analogchipper/NanoArchitects_Chipathon2026/README_backup.md

# Gas Sensor AFE ASIC — Team NanoArchitects

**IEEE SSCS Chipathon 2026, Track B** · GF180MCU 180nm CMOS PDK

Dual-modal analog front-end ASIC for simultaneous MOX (metal-oxide) and EC (electrochemical) gas sensing.

| Feature | Description |
|---|---|
| **EC sensors** | Selective but slow — good for identifying gas type |
| **MOX sensors** | Fast response but lack selectivity — good for real-time detection |
| **Both in parallel** | Enables real-time cross-validation |
| **Target applications** | Industrial toxic-gas detection (CO, H₂S), VOC monitoring, process control |

## Block Diagram

GasSensorChip_Chipathon drawio(1)

## Status: All blocks complete ✅

| Block | Status |
|---|---|
| EC TIA | ✅ Complete |
| MOX Integrator + Reset Sw. | ✅ Complete |
| Output Buffers | ✅ Complete |
| Bias Generator (BGR) | ✅ Complete |
| Comparators | ✅ Complete |

## Key Specifications

### Op-Amp (`opamp_poly`)

📄 [Full Datasheet (PDF)](docs/datasheets/OPAMP_Datasheet.pdf)

| Parameter | Value |
|---|---|
| Open-Loop Gain | 80.3 dB |
| Unity-Gain BW | 154.6 MHz |
| Phase Margin | 70.2° |
| CMRR | 102.8 dB |
| PSRR | 81.9 dB |
| Slew Rate (+/-) | 194.4 / 96.0 V/µs |
| Input Common-Mode Range | 38 mV – 3.06 V |
| Output Swing | 0 V – 3.23 V @ VDD = 3.3 V |
| Quiescent Current | 943 µA |

### EC Channel — TIA

| Parameter | Value |
|---|---|
| Open-Loop Gain | 74 dB |
| Phase Margin | 65° (unconditionally stable) |
| Bandwidth | 5 MHz |
| Rf ∥ Cf | 7 kΩ ∥ 9 pF |
| Input Range | 100 nA (2.7995 V) – 373 µA (0.935 V) |
| Full Swing | ≈ 1.865 V, single output, no range switching |

### MOX Channel — Integrator (Methane sensor)

| Parameter | Value |
|---|---|
| Clean-Air Resistance (R0) | 20–70 kΩ |
| Gas-Present Resistance (RS) | 2–20 kΩ @ 5000 ppm methane |
| Integrator Current Range | 14 µA – 500 µA |
| System Parameters | Vp = 1.3 V, ΔV = 0.5 V, Cint = 10 µF |
| Reset Pin | `RESET_INT`, active-high, MCU-controlled |

### Bias Generator (BGR)

| Parameter | Value |
|---|---|
| Reference Voltage | 1.2 V bandgap core, scaled to Vp = 2.8 V |
| Supply Voltage | 3.3 V |
| Temp. Coefficient | < 50 ppm/°C |
| Power Consumption | < 50 µA |

**Multi-rail bias distribution.** The BGR core outputs a single reference (`Vref`), which is buffered through `OPAMP_silicon` (unity-gain, driven from the same op-amp used elsewhere on-chip) and then divided through a resistor ladder (R1–R4) to generate every bias voltage the other blocks need: `v_2.8` (EC TIA virtual ground), `voref`, and `v_1.3` / `v_0.8` (MOX integrator system voltages). Using a single buffered reference plus a resistor ladder — instead of separate bandgap cores per block — keeps all bias points ratiometrically matched and saves die area.

## Pin Assignment (~15 pads)

Pin Assignment

## Estimated Die Area

**Total: 0.5 – 0.6 mm²**

---

## Simulation Results

### Op-Amp

**🔗 [View Op-Amp schematic file (`opamp_poly.sch`)](xschem/opamp/opamp_poly.sch)**

| Schematic | AC Bode (Gain 80 dB) | Phase Margin (70°) |
|---|---|---|
| Opamp Schematic | AC Bode | Phase |

| CMRR (102 dB) | PSRR (81.9 dB) | ICMR(0.2 - 3.1 V) |
|---|---|---|
| CMRR | PSRR | ICMR |

**Slew Rate:** rising SR = 194.4 V/µs, falling SR = 96.0 V/µs — asymmetry expected due to sourcing/sinking drive imbalance in the output stage (confirmed against datasheet).

Slew Rate
**Op-Amp Summary:** The AC response confirms a high open-loop gain (>80 dB) and excellent stability with a 70.2° phase margin. High CMRR (>102 dB) and PSRR (>81 dB) ensure the amplifier remains highly robust against supply noise and common-mode fluctuations, which is essential for accurate, low-noise sensor signal conditioning. 

### Output Buffers

**🔗 [View Buffer schematic file (`buffer.sch`)](xschem/output_buffer/buffer.sch)**

**Buffer Schematic:**
Output Buffer Schematic

**Transient Waveform:**
Buffer Transient Waveform

**Buffer Summary:** The operational amplifier buffer provides essential signal isolation and drive capabilities. It is instantiated twice within the AFE architecture: (1) to provide sufficient drive strength to pass the EC TIA output voltage to an off-chip ADC, and (2) to supply a highly stable, low-impedance reference bias to the MOX integrator. The transient simulations verify that the buffer faithfully tracks dynamic signals with excellent settling time and minimal distortion under load.

### Comparators

**🔗 [View Comparator schematic file (`comparator.sch`)](xschem/comparator/comp.sch)**

**Comparator Schematic:**
Comparator Schematic

**Transient Waveform:**
Comparator Transient Waveform

 **Comparator Summary:** The comparator acts as the critical bridge between the analog sensor front-end and the digital logic domain, providing precise threshold detection to trigger system alerts or wake-up events when gas concentrations exceed predefined safety levels. The transient simulation validates its fast response and confirms its inverting topology: the output drives low (0) when the sensor signal exceeds the reference voltage (Vin > Vref), and transitions high (1) when it drops below the threshold. This active-low configuration ensures reliable event triggering for downstream digital processing.

---
### EC TIA

**🔗 [View TIA schematic file (`TIA.sch`)](xschem/ec_tia/TIA.sch)**

**🔗 [View Top-Level Sensor System schematic file (`ECSensorSim.sch`)](xschem/ec_tia/ECSensorSim.sch)**

TIA Schematic

**AC response and DC linearity:**

| AC Bode | DC Sweep (Vout vs Iin) |
|---|---|
| TIA AC Bode | TIA DC Sweep |

**Input/output noise spectrum:**

| Input-Referred Noise | Output Noise |
|---|---|
| Input Noise | Output Noise |

**Gas response (CO sensor):**

| Sensor Concentration(ppm) vs Current(uA) | Sensor Concentration(ppm) vs ADC code |
|---|---|
| Sensor Concentration(ppm) vs Current(uA) | Sensor Concentration(ppm) vs ADC |
**TIA Summary:** The Transimpedance Amplifier achieves excellent DC linearity across the entire 100 nA to 373 µA input range, directly translating into accurate ppm gas readings. The AC Bode plot confirms unconditional stability (65° phase margin), while the noise spectrum analysis demonstrates minimal input-referred noise—a critical requirement for resolving minute electrochemical sensor currents.

### MOX Integrator

**🔗 [View MOX Integrator schematic file (`integrator.sch`)](xschem/mox_integrator/int.sch)**

**Integrator Schematic:**
MOX Integrator Schematic

**Transient Waveform:**
MOX Integrator Transient Waveform
MOX Integrator Transient Waveform

Note:To prevent the reset mechanism from stalling, the lower comparator threshold is set to 1.5V keeping it safely above the 1.3V reference
**MOX Integrator Summary:** The MOX sensor acts as a variable resistor where its resistance changes according to the environmental gas concentration. This varying resistance dictates the amount of current entering the integrator's capacitor, which changes the time it takes for the output voltage to ramp from a 1.3V reference baseline up to a 2.5V threshold. An external MCU measures this specific ramp time to accurately determine the sensor resistance, which directly reflects the real-time gas concentration as can be seen in the above results.
### Bias Generator (BGR)

**🔗 [View BGR schematic file (`BGR_BJT.sch`)](xschem/bias_generator/BGR_BJT.sch)**

**BGR Core Schematic:**
BGR Schematic

**Multi-Bias Distribution Schematic:**
Multi-Bias Distribution Schematic

**Simulation Results:**
BGR U-curve
Multiple Bias Generation
**BGR Summary:** The U-curve validates a highly stable reference voltage with a temperature coefficient of less than 50 ppm/°C across the target thermal operating range. The multi-bias generation network successfully buffers and scales this core voltage to provide clean, ratiometrically matched sub-rails (2.8V, 1.3V, and 0.8V) for all other on-chip blocks.
---

### Overall Circuit

**Circuit Schematic:** [Insert Link]

**Circuit Simulation Demo Video:** [Insert Link]

**System Simulation Results**

#### EC TIA System Linearity
Full-system simulations under load(worst case load value was taken 100pF) indicate a maximum linear TIA current limit of 340 µA. This comfortably exceeds the requirements of our target application, as the most demanding sensor (Carbon Monoxide) reaches a maximum output of only 102 µA at 1000 ppm. The table below characterizes the TIA's linearity up to this physical saturation limit (Mean Absolute Deviation: 1.97%).

| Vref (V) | I (µA) | Vout Calculated (V) | Vout Simulated (V) | Deviation (%) |
| :--- | :--- | :--- | :--- | :--- |
| 2.726 | 20 | 2.586 | 2.583 | -0.12% |
| 2.726 | 60 | 2.306 | 2.297 | -0.39% |
| 2.726 | 100 | 2.026 | 2.011 | -0.74% |
| 2.726 | 140 | 1.746 | 1.732 | -0.80% |
| 2.726 | 180 | 1.466 | 1.447 | -1.30% |
| 2.726 | 220 | 1.186 | 1.161 | -2.11% |
| 2.726 | 260 | 0.906 | 0.8747 | -3.45% |
| 2.726 | 300 | 0.626 | 0.5895 | -5.83% |
| 2.726 | 340 | 0.346 | 0.3522 | 1.79% |

#### MOX Integrator System Characterization
The table below validates the system-level integrator performance across heavy gas leaks (2 kΩ) to clean air baselines (60 kΩ), demonstrating an exceptionally low Mean Absolute Deviation of just 2.79% from theoretical calculations.

| VR (V) | C (nF) | Rs (kΩ) | Calculated Time (ms) | Simulated Time (ms) | Deviation (%) |
| :--- | :--- | :--- | :--- | :--- | :--- |
| 0.5 | 33 | 2 | 0.132 | 0.1288 | -2.42% |
| 0.5 | 33 | 20 | 1.320 | 1.3386 | +1.41% |
| 0.5 | 33 | 60 | 3.960 | 3.7799 | -4.55% |

## Repository Structure

├── docs/
│   ├── datasheets/      Component datasheets (PDF)
│   └── images/          Diagrams and simulation plots used in this README
├── xschem/              Schematic source files (.sch, .sym), one folder per block
│   ├── bias_generator/
│   ├── comparator/
│   ├── ec_tia/
│   ├── mox_integrator/
│   ├── opamp/
│   ├── output_buffer/
│   └── afe_top/       Overall AFE system integration schematic
├── simulations/          Testbenches and .raw sim data
└── layout/               (in progress) GDS/layout files, DRC/LVS reports
```
## Team NanoArchitects

- Alaqmar
- Ankith B.
- Rishi Raghav S.
- Shaik Kareena
