analogchipper/NanoArchitects_Chipathon2026/(commit log)

2026-07-04 Update README.md for clarity and formatting
    Removed out-of-range note for H₂S sensor and cleaned up team member list formatting.
2026-07-10 README Updated
    [ECSensorSim.sch, ECSensorSim_dc.sch, ECSensorSim_ppm.sch, ECSensorSim_ppm_CO.sch, ECSensorSim_ppm_H2S.sch, TIA.sch, TIA_PVT_phase_sil.sch, TIA_PVT_sil.sch]
2026-07-10 update README with opamp/TIA/BGR sim results and datasheet link
    [BGR_BJT.sch, BGR_BJT_dc.sch, ECSensorSim.sch, ECSensorSim_dc.sch, ECSensorSim_ppm.sch, ECSensorSim_ppm_CO.sch, ECSensorSim_ppm_H2S.sch, TIA.sch]
2026-07-10 add BGR multi-bias distribution schematic and explanation
2026-07-12 Update README with multi-bias distribution schematic
    Added multi-bias distribution schematic image to README.
2026-07-12 added sch files
    [BGR_OP.sch, opamp.sch]
2026-07-12 updated README and added Buffer
    [buffer.sch]
2026-07-12 updated Buffer schematic image
2026-07-12 updated README and added COmparator and buffer
    [comp.sch, comp_tb.sch]
2026-07-12 upadted README, added integrator
    [int.sch, int_tb.sch]
2026-07-12 Updated the comparator schematic and images
    [comp.sch]
2026-07-14 updated README and added top level sch
    [ECMOX_tran.sch]
2026-07-29 Revise TIA and MOX integrator data in README
    Updated TIA current limit and MOX integrator performance tables with new data points for Vref and VR values.
